dhaneshweb/Stethoscope/README.md

# Digital Stethoscope 数字听诊器

模拟电子技术课程制作

## Contributors
- [yaoht](https://github.com/yht1995)
- [gjc](https://github.com/gjc13)

## Hardware
- TI TLV320 Codec
- NXP LPC1768 MCU

## Firmware
The Firmware is based on ARM mbed

ARM mbed
