dhaneshweb/Stethoscope/Report/Stethoscope.pdf

# 数字听诊器 Digital Stethoscope

### 郭嘉丞 姚皓天

2015年6月

2 系统设计
1 简介

### 1.1 设计目的

听诊器是一种常用的医疗设备，在初步诊断中有重要的作用。传统的听诊器对于人体内部的声音型 号是一个固定的低通系统，具有很高的信噪比但是通带与放大倍数都不可调。同时也不能够记录听到的 声音用于回放进行详细诊断以及教学。针对这些问题，电子听诊器被设计出来进行放大，滤波与录音。 在本次课程设计中我们自己搭建了一个电子听诊器。完成硬件设计、调试以及软件编程的工作。

### 1.2 基本功能

1. 能够采集到人体内部的声音信号进行放大与回放
2. 能够存储听诊器中听到的声音

### 1.3 可以拓展的功能

1. 提供不同的滤波模式用于不同种声音的采集
2. 实现心跳次数的自动测量
3. 能够实现在呼吸音和心跳音混合的情况下提取并放大较弱的呼吸音。

这些功能由于时间所限没有完成，其中不同滤波模式可以考虑增加可调滤波电路或者使用数字滤波器完 成，而之后的两个功能主要是信号处理的内容，与模拟电子部分关系不大。

## 2 系统设计

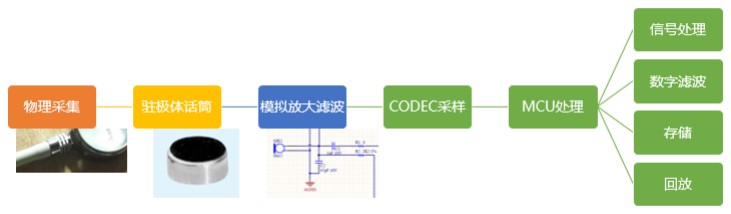
[picture p25: figure]

Figure 1: 系统总体框图

2

3 硬件设计细节


Figure 2: 实际产品图片

物理采集系统直接使用了购买的听诊器中的听筒与导管，放入驻极体话筒后密封。导管本身就带有 了物理放大的功能。之后对驻极体话筒采集到的信号使用共源放大电路进行放大。之后使用专用音频 CODEC进行采样以及模拟输出，也就是ADC/DAC。对于已经数字化的信号使用微控制器NXP1768进行处理， 可以进行保存，回放，滤波等信号处理工作。

## 3 硬件设计细节

### 3.1 电源部分

电源是系统中容易被忽视，但是又非常重要关乎系统性能的关键部分。 本设计中含有数字部分和模拟部分，各自使用独立的电源：

- 数字部分采用 Step-Down(Buck) Converter
- 模拟部分采用 High PSRR, Low Noise, Single Output LDO

3.1.1 数字电源


Figure 3: 开关电源

数字部分采用Richtek RT8008-3.3供电。这款芯片具有以下特点：

1. 固定输出电压3.3V

3

2. 1.5MHz的PWM频率，可以使用小型的外部电感和电容
3. 内置场效应管，采用同步整流方式，具有较高的效率

由于具有效率高，体积小，占用PCB面积小的特点，非常适合为本设计的数字部分供电，也利于手持 设备小型化。
图中DS3用作电源指示灯。

3.1.2 模拟电源

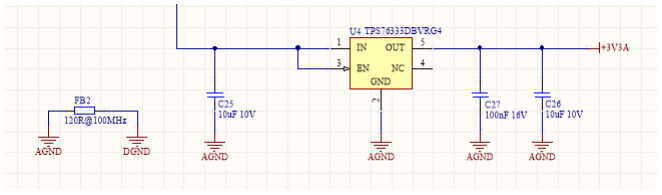
[picture p26: figure]

Figure 4: 线性电源

模拟部分采用TI TPS79333供电。这款芯片具有以下特点：

1. 高PSRR(70 dB at 10 kHz)
2. 低噪声(32 µVRMS)

该芯片可以有效抑制电源噪声，提供符合模拟部分工作的低噪声电源。
图中FB2 采用120R@100MHz的磁珠将模拟地与数字地相连，可以避免数字部分对模拟部分的干扰。

### 3.2 模拟前端和数据转换

模拟前端和数据转换采用TI Audio Codec TLV320AIC23B为核心，辅以外部电路，实现声音信号和数 字信号的双向转换。

3.2.1 话筒输入

我们采用驻极体话筒采集听诊器中的声音信号。驻极体话筒是可以看做一个已经连有输入的MOS管。 其等效电路如下：


Figure 5: 话筒等效电路

4

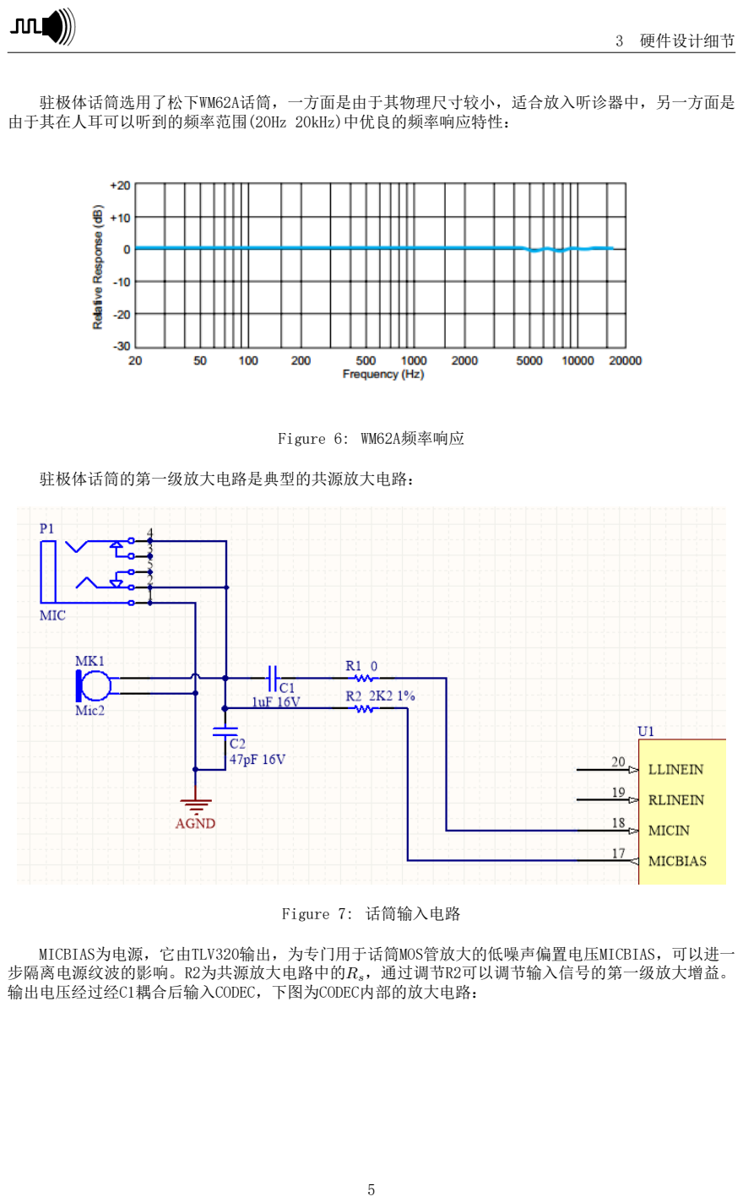
[picture p27: page 5]

驻极体话筒选用了松下WM62A话筒，一方面是由于其物理尺寸较小，适合放入听诊器中，另一方面是 由于其在人耳可以听到的频率范围(20Hz 20kHz)中优良的频率响应特性：

Figure 6: WM62A频率响应

驻极体话筒的第一级放大电路是典型的共源放大电路：

Figure 7: 话筒输入电路

MICBIAS为电源，它由TLV320输出，为专门用于话筒MOS管放大的低噪声偏置电压MICBIAS，可以进一 步隔离电源纹波的影响。R2为共源放大电路中的Rs，通过调节R2可以调节输入信号的第一级放大增益。 输出电压经过经C1耦合后输入CODEC，下图为CODEC内部的放大电路：

5

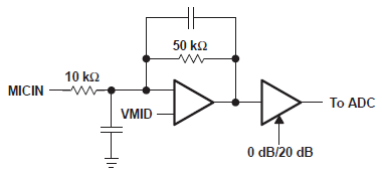
[picture p28: figure]

Figure 8: 集成次级放大滤波电路

第一级运放进行滤波和放大，在通带构成了一个放大倍数为5倍的放大电路，同时对20kHz以上的高 频进行滤波，所以在设计时没有增加外部滤波电路。

3.2.2 耳机输出


Figure 9: 耳机输出电路

由于芯片内置耳放，所以输出信号的左右声道分别直接通过C3和C4耦合至耳机输出即可。

6

3.2.3 CODEC的数字接口


Figure 10: CODEC的数字接口

CODEC与MCU之间通过数字接口相连。控制接口为I2C接口，用于配置COEDC的输入输出方式，可编程 放大器的放大增益，信号流向等。音频数据采用I2S接口相连。

### 3.3 微控制器和其他数字外设

3.3.1 微控制器

微控制器采用NXP LCP1768。微控制器为ARM Cortex-M3内核。

7


Figure 11: LPC1768内部框图

3.3.2 TF-Card


Figure 12: TF-Card

8

3.3.3 USB接口

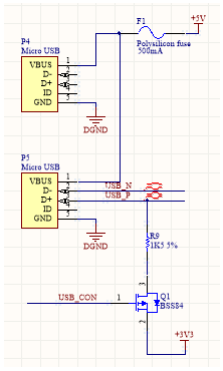
[picture p29: figure]

Figure 13: USB接口

P4接口用于给系统供电，电源入口串有多晶硅熔丝，用于对系统和外部电源的保护。P5接口用于接 驳其他的USB外部设备（如U盘）或者连接个人计算机。

3.3.4 调试接口


Figure 14: 调试接口

留有两种调试接口。其中SWD Debug Port可以连接通用的调试工具。而标准的Cortex Debug+ETM connector可以用于连接ARM U-Link Pro等带有Trace功能的调试工具，提供更加丰富的调试功能。

9

3.3.5 其他外设


Figure 15: 旋钮


Figure 16: 按键

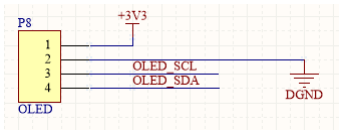
[picture p30: figure]

Figure 17: OLED屏幕

这些外设可以用于扩展功能。

10

5 软件设计

## 4 PCB设计

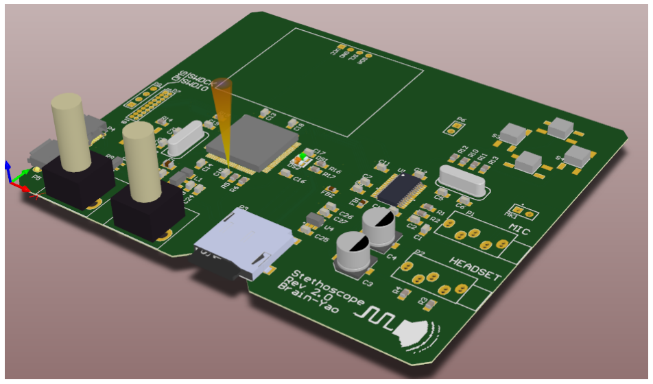
[picture p31: figure]

Figure 18: PCB三维渲染图

PCB设计采用Altium Designer 设计，按照通常混合信号系统的设计方法，数模部分分开布局。数字 地、模拟地按布局切分，单点相连。

## 5 软件设计

使用的开源库：

1. 软件设计中使用了ARM开发的基础库 mbed。 (https://developer.mbed.org/users/mbed_official/code/mbed/)
2. 二次开发了Daniel Worrall 开发的 TLV320驱动库，增加了模拟输入功能以及对应的芯片配置。 (https://developer.mbed.org/cookbook/TLV320AIC23B)
3. 使用了Daniel Worrall 开发的 I2S Slave协议库和 (https://developer.mbed.org/users/d_worrall/code/I2SSlave/) Giles Barton-Owen开发的 I2S Master协议 库用于和CODEC芯片TLV320的通信。 (https://developer.mbed.org/users/p07gbar/code/I2S/)

所有的代码都发布在开源社区github上。 (https://github.com/gjc13/Stethoscope)

11

5 软件设计

### 5.1 滤波器设计

5.1.1 抗噪滤波器


Figure 19: 原始声音频谱图

通过对采集的声音短时傅里叶变换后的频谱图的分析，主要的能量分布在1kHz以下的频段，所以使 用了8kHz采样率，并且增加了一个8阶的均值滤波器用来滤去高频噪声：
滤波器传递函数为： ∑
7

k=0

z

−k
8 滤波器的频率响应特性如下，截止频率大约在1100Hz左右：

12

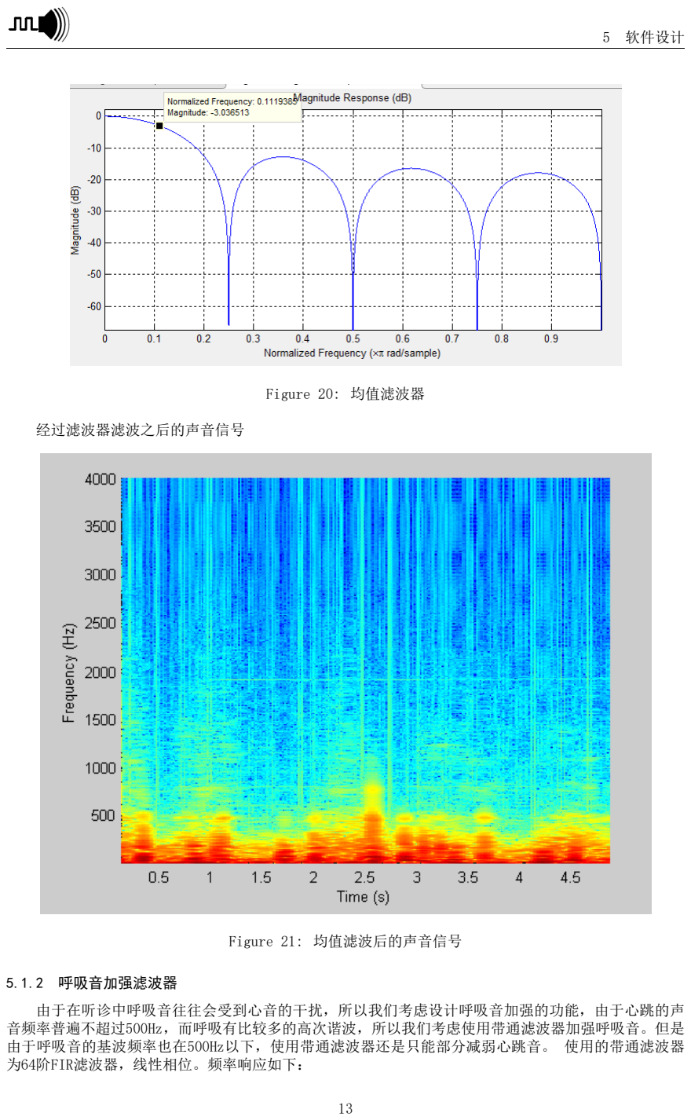
[picture p32: page 13]

5 软件设计

Figure 20: 均值滤波器

经过滤波器滤波之后的声音信号

Figure 21: 均值滤波后的声音信号

5.1.2 呼吸音加强滤波器

由于在听诊中呼吸音往往会受到心音的干扰，所以我们考虑设计呼吸音加强的功能，由于心跳的声 音频率普遍不超过500Hz，而呼吸有比较多的高次谐波，所以我们考虑使用带通滤波器加强呼吸音。但是 由于呼吸音的基波频率也在500Hz以下，使用带通滤波器还是只能部分减弱心跳音。 使用的带通滤波器 为64阶FIR滤波器，线性相位。频率响应如下：

13

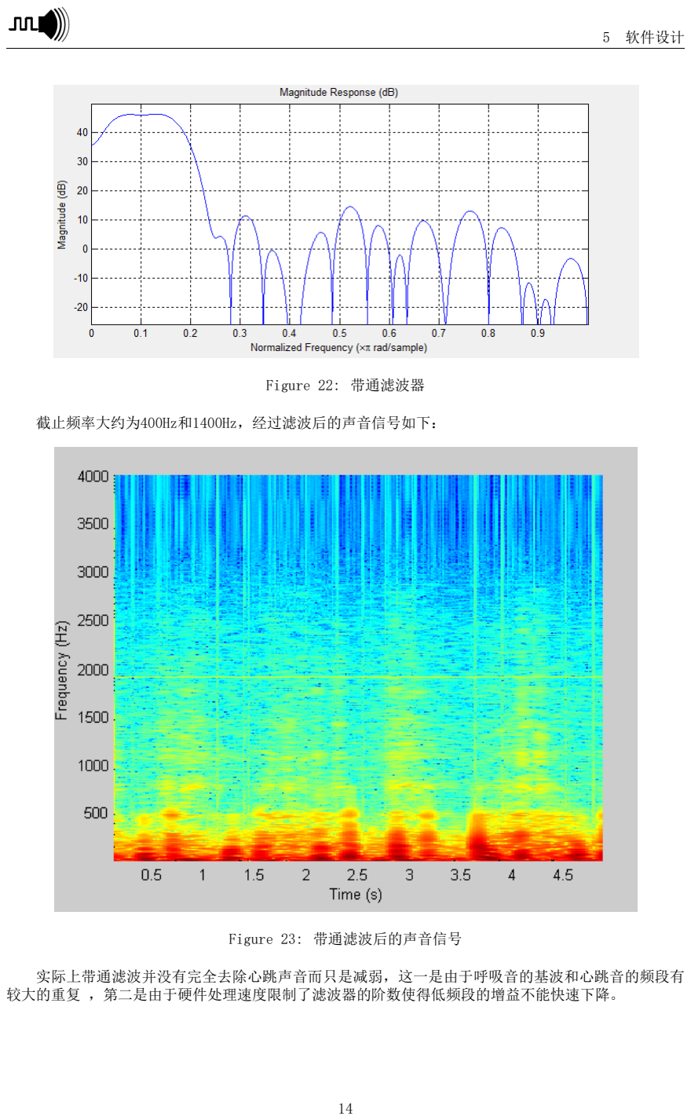
[picture p33: page 14]

5 软件设计

Figure 22: 带通滤波器

截止频率大约为400Hz和1400Hz，经过滤波后的声音信号如下：

Figure 23: 带通滤波后的声音信号

实际上带通滤波并没有完全去除心跳声音而只是减弱，这一是由于呼吸音的基波和心跳音的频段有 较大的重复 ，第二是由于硬件处理速度限制了滤波器的阶数使得低频段的增益不能快速下降。

14

7 阶段总结与展望

## 6 测试效果

在附件中包含了录下的心跳呼吸混合声音，avgfiltered.wav是均值滤波后的效果，而bandpass.wav 是呼吸音加强的带通滤波器处理的效果。由于codec已经有比较大的输出放大倍数，所以录音音量较小， 在电脑上听时需要调高音量。 我们对采集到的心跳声音在电脑上使用Matlab进行分析，得到的频谱图如 下：

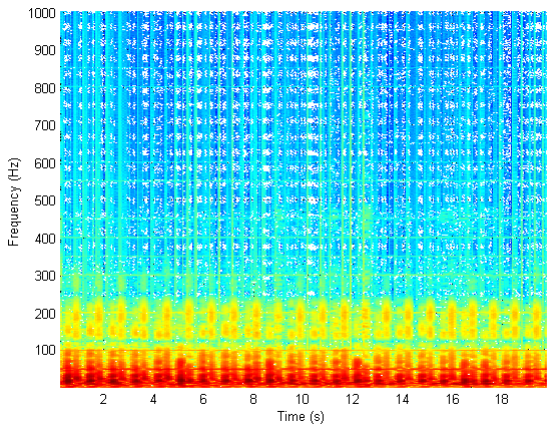
[picture p34: figure]

Figure 24: 心跳声音频谱图

可以明显看到第一心音和第二心音的不同以及1Hz左右反复出现的心跳信号。实测发现呼吸音和心跳 音在实际测试中都没有超过2kHz，所以我们考虑之后在输入级增加低通滤波电路以进一步提高信噪比。 和传统的听诊器对比，高频响应和放大倍数都有了明显提升，原来较弱的呼气音可以清晰的听到。 但是信噪比不及传统听诊器，这是由于电路内部引入了不可避免的噪声，还需要进行电路设计的优化和 数字滤波的处理来进一步增强信噪比。

## 7 阶段总结与展望

### 7.1 取得的成果

1. 设计了整体的数模混合的听诊器声音采集系统
2. 完成了所有的芯片的软硬件调试工作
3. 进行了初步的信号采集与分析
4. 设计了不同的滤波器用于滤波和特定频段放大

### 7.2 阶段感受

在信号课程设计的过程中，我们完成了一个完整的信号处理系统的软硬件设计。其中尤其大的感受 是信号处理是需要各个方面大量的软硬件技术配合才能达到比较好的效果。比如在我们的调试过程中， 初期噪声总是非常大，如果使用低通滤波器尽心降噪需要将截止频率降到200Hz左右，呼吸音几乎一斤 完全听不到。但是通过对硬件的调试，发现sd卡槽的金属盖没有接地，将其接地后立刻就大大降低了噪 声。同时许多软件算法也会受到硬件的限制，NXP1768处理器的处理能力以及RAM大小都限制了我们不能

15

7 阶段总结与展望

使用很高阶的滤波器以及处理必须是实时的，不可能进行存储后再处理，也对软件设计提出了很多挑 战，同时影响了一些最终滤波的效果。

### 7.3 之后的工作与展望

1. 根据听诊器声音信号的特点，在前级进一步添加截止频率在2kHz左右的低通滤波电路以减小噪声。
2. 进一步开发心跳检测呼吸检测等功能。

16
