dhaneshweb/Stethoscope/(list of files, drawings)

Other design files:
PCB/Codec.SchDoc
PCB/MCU.SchDoc
PCB/Power.SchDoc
PCB/Stethoscope.PcbDoc
PCB/Stethoscope.PrjPcb
