dhaneshweb/Stethoscope/(commit log)

2015-07-02 band pass filter
2015-07-02 add new filters
2015-08-31 [ADD] PCB
    [Codec.SchDoc, MCU.SchDoc, Power.SchDoc, Stethoscope.PcbDoc, Stethoscope.PrjPcb]
